PLAN-IT-B/BachelorProefTrainGame/deadlines/Blokschema/escaperoom blokschema.pdf

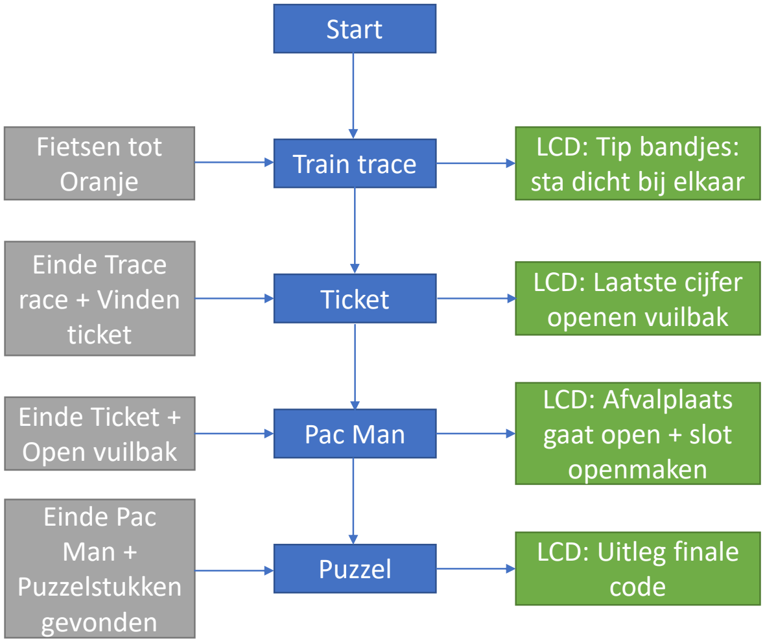
[picture p1: figure]
Train trace; Ticket; Pac Man; Puzzel; LCD: Tip bandjes: sta dicht bij elkaar; LCD: Laatste cijfer openen vuilbak; LCD: Afvalplaats gaat open + slot openmaken; LCD: Uitleg finale code; Fietsen tot Oranje; Einde Trace race + Vinden ticket; Einde Ticket + Open vuilbak; Einde Pac Man + Puzzelstukken gevonden; Start

### Minimale zone: Oranje

### Besturing via joystick

### Trein volgt de led strip

Train race (Simon Sais):
1) Eerst wordt er snel een voorbeeld route afgespeeld.
2) Deze route moet exact gevolgd worden om deze puzzel te doen slagen.

Ticket:
Vindt het ticket in de kamer, hierop staat een begin- en eindadres. Volg de kortste weg van begin tot eind om de puzzel op te lossen.

Pac Man:
Het doel van deze puzzel is om gedurende een bepaalde tijd
alle andere treinen te ontwijken. Als je lang genoeg kan blijven rijden Zonder te botsen is de puzzle opgelost.

Puzzel:
Vindt alle puzzelstukken in de kamer, en los deze op. Wanneer de puzzel Opgelost is dient deze als template om de juiste route te kunnen volgen. Als de trein deze route gevolgd heeft is deze puzzel opgelost.
