PLAN-IT-B/BachelorProefTrainGame/deadlines/PuzzelKaart.pdf

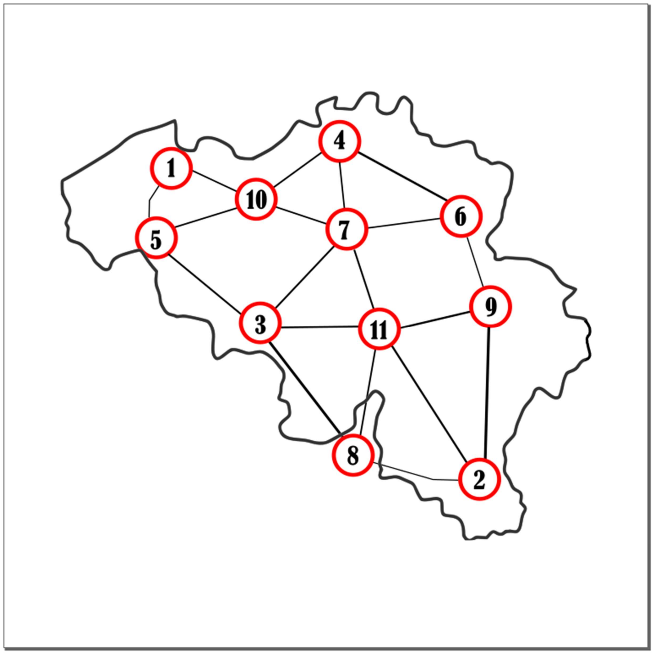
[picture p2: page 1]
