PLAN-IT-B/BachelorProefTrainGame/Verslag/3D-modellen/Puzzelstukken/TotalePuzzel.STL

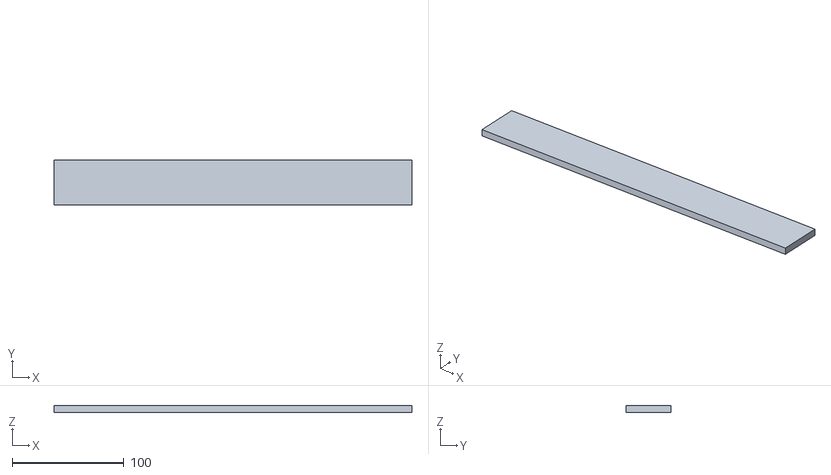
[picture p3: CAD file, 2022-05-24]
Verslag/3D-modellen/Puzzelstukken/TotalePuzzel.STL
320.0 x 40.0 x 6.00
