PLAN-IT-B/BachelorProefTrainGame/Verslag/Lasercut_Solidworks/Box/Box_totaal.SLDASM

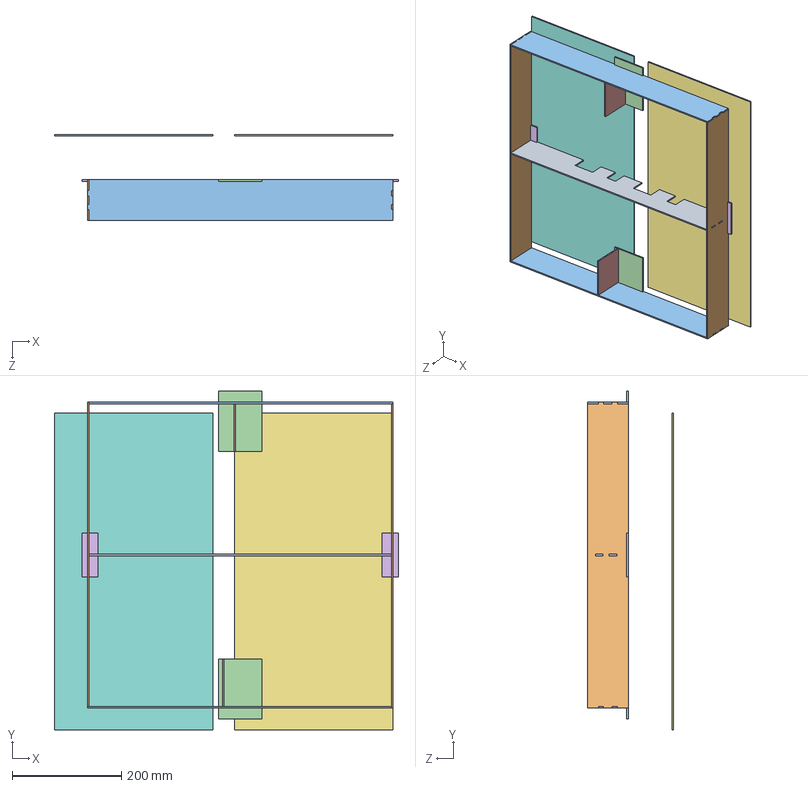
[picture p4: CAD file, 2022-05-19]
Verslag/Lasercut_Solidworks/Box/Box_totaal.SLDASM
630.0 x 620.0 x 158.0 mm
MID
SIDE_UPnDOWN x 2
SIDE_LR x 2
PLAAT_groot x 2
Ondersteuning_Mid x 2
PLAAT_klein x 2
PLAAT_boven
PLAAT_onder
