PLAN-IT-B/BachelorProefTrainGame/Verslag/3D-modellen/Bouwonderdelen Spelbord/Doos.STL

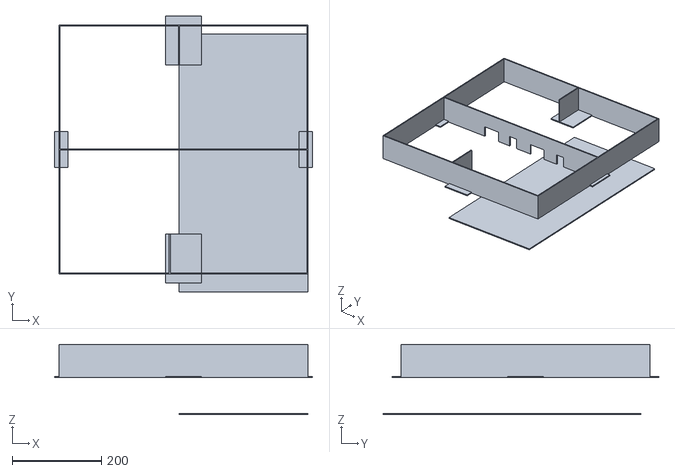
[picture p5: CAD file, 2022-05-24]
Verslag/3D-modellen/Bouwonderdelen Spelbord/Doos.STL
580.0 x 620.0 x 158.0
