PLAN-IT-B/BachelorProefTrainGame/Verslag/Lasercut_Solidworks/PUZZEL_SW/STUK_7.SLDPRT

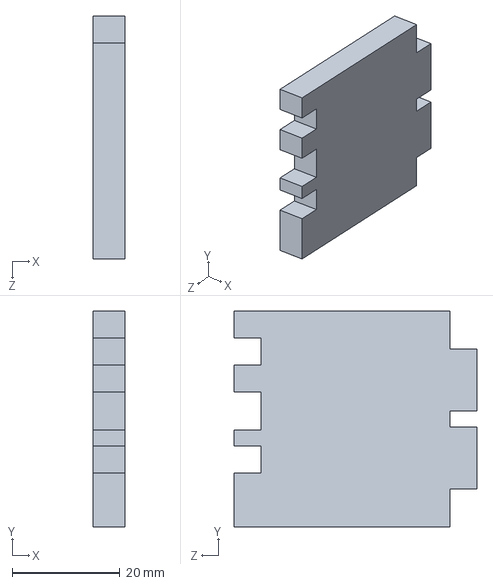
[picture p7: CAD file, 2022-05-21]
Verslag/Lasercut_Solidworks/PUZZEL_SW/STUK_7.SLDPRT
6.00 x 40.0 x 45.0 mm
