PLAN-IT-B/BachelorProefTrainGame/Verslag/3D-modellen/Bouwonderdelen Spelbord/Box_totaal - Ondersteuning_Mid-2.STL

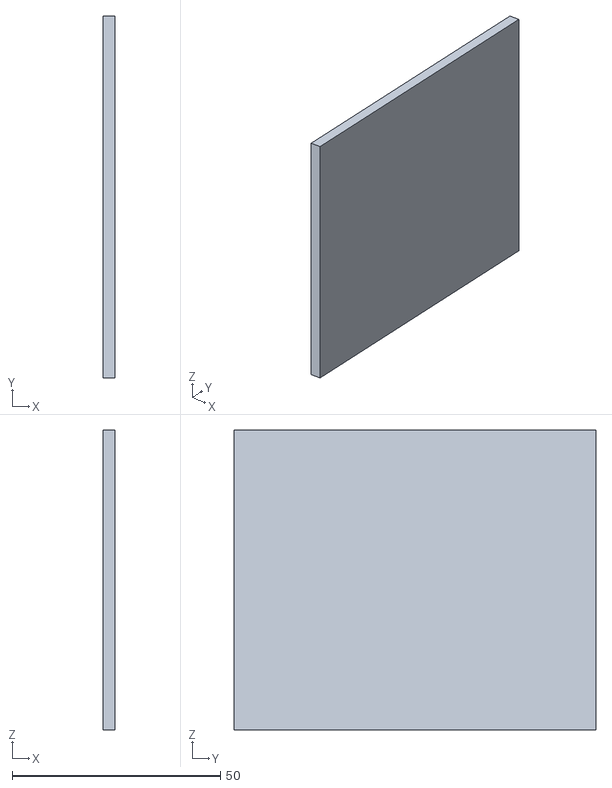
[picture p8: CAD file, 2022-05-20]
Verslag/3D-modellen/Bouwonderdelen Spelbord/Box_totaal - Ondersteuning_Mid-2.STL
3.00 x 87.0 x 72.0
