PLAN-IT-B/BachelorProefTrainGame/Verslag/3D-modellen/Puzzelstukken/PUZZEL_DXF/STUK_8.DXF

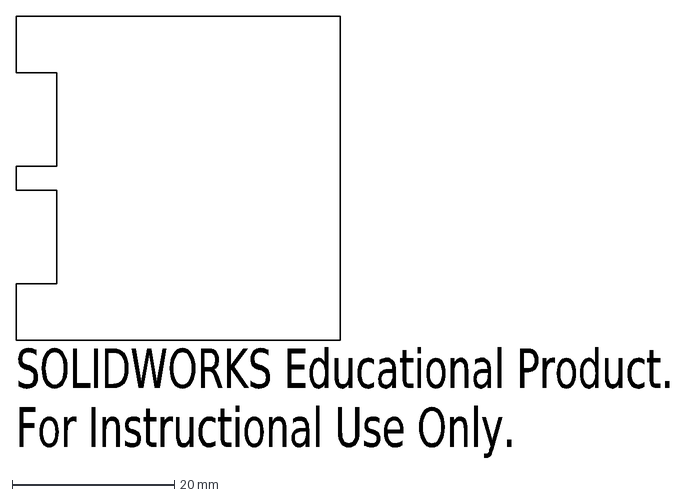
[picture p9: CAD file, 2022-05-24]
Verslag/3D-modellen/Puzzelstukken/PUZZEL_DXF/STUK_8.DXF
SOLIDWORKS Educational Product.
For Instructional Use Only.
