PLAN-IT-B/BachelorProefTrainGame/Verslag/Lasercut_Solidworks/Box/PLAAT_klein.SLDPRT

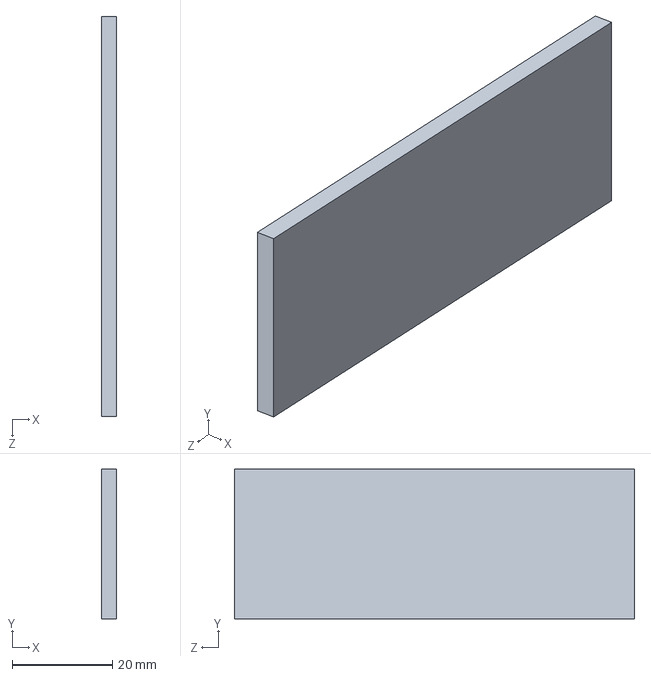
[picture p10: CAD file, 2022-05-19]
Verslag/Lasercut_Solidworks/Box/PLAAT_klein.SLDPRT
3.00 x 30.0 x 80.0 mm
