PLAN-IT-B/BachelorProefTrainGame/Verslag/3D-modellen/Bouwonderdelen Spelbord/Box_totaal - MID-1.STL

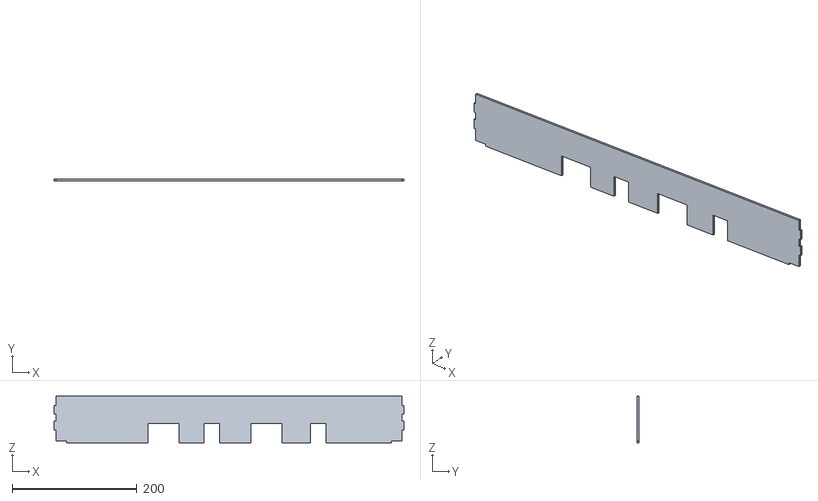
[picture p12: CAD file, 2022-05-20]
Verslag/3D-modellen/Bouwonderdelen Spelbord/Box_totaal - MID-1.STL
560.0 x 3.00 x 75.0
