PLAN-IT-B/BachelorProefTrainGame/Verslag/3D-modellen/Puzzelstukken/PUZZEL_DXF/STUK_6.DXF

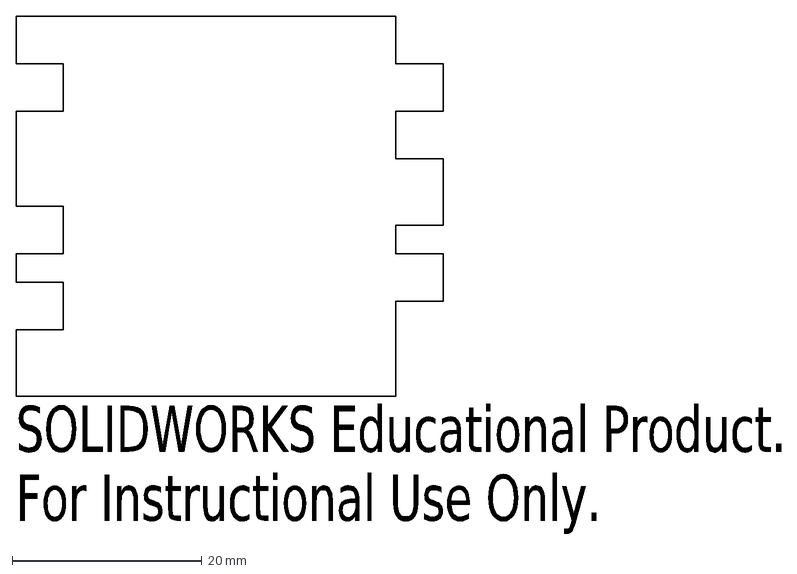
[picture p13: CAD file, 2022-05-24]
Verslag/3D-modellen/Puzzelstukken/PUZZEL_DXF/STUK_6.DXF
SOLIDWORKS Educational Product.
For Instructional Use Only.
