PLAN-IT-B/BachelorProefTrainGame/Verslag/Lasercut_Solidworks/Box/SIDE_UPnDOWN.SLDPRT

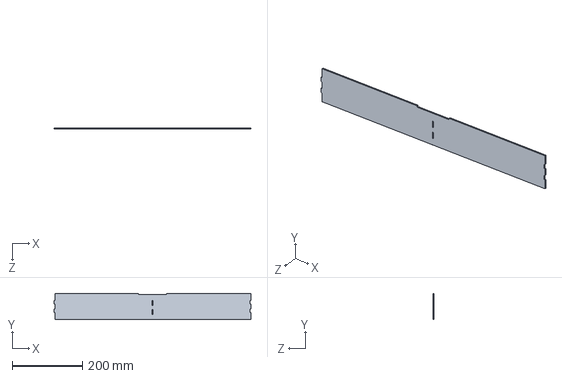
[picture p14: CAD file, 2022-05-19]
Verslag/Lasercut_Solidworks/Box/SIDE_UPnDOWN.SLDPRT
560.0 x 75.0 x 3.00 mm
