PLAN-IT-B/BachelorProefTrainGame/Verslag/Lasercut_Solidworks/Box/PLAAT_boven.SLDPRT

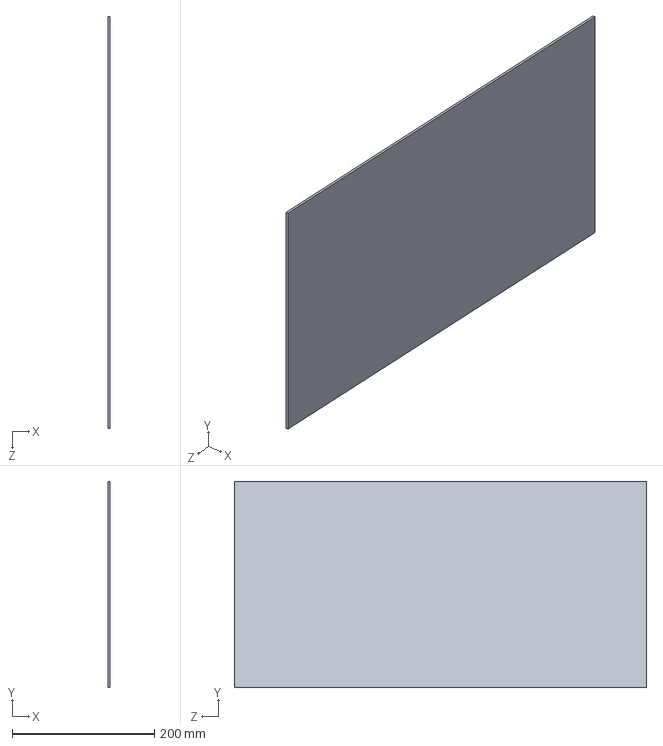
[picture p16: CAD file, 2022-05-19]
Verslag/Lasercut_Solidworks/Box/PLAAT_boven.SLDPRT
3.00 x 290.0 x 580.0 mm
