PLAN-IT-B/BachelorProefTrainGame/Verslag/3D-modellen/Bouwonderdelen Spelbord/Box_totaal - PLAAT_groot-3.STL

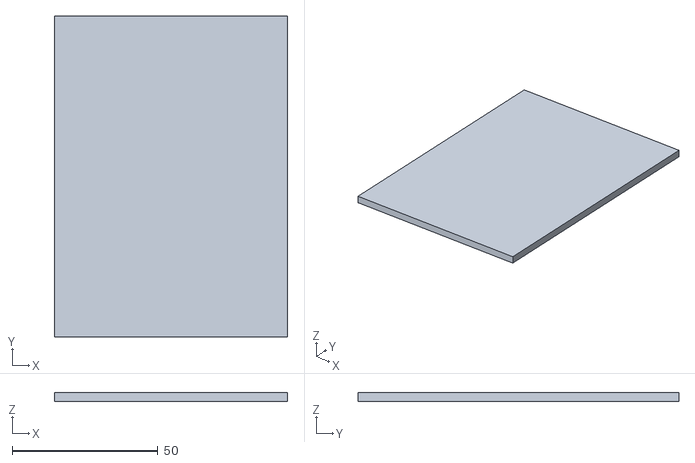
[picture p17: CAD file, 2022-05-20]
Verslag/3D-modellen/Bouwonderdelen Spelbord/Box_totaal - PLAAT_groot-3.STL
80.0 x 110.0 x 3.00
