PLAN-IT-B/BachelorProefTrainGame/Verslag/Lasercut_Solidworks/PUZZEL_SW/STUK_8.SLDPRT

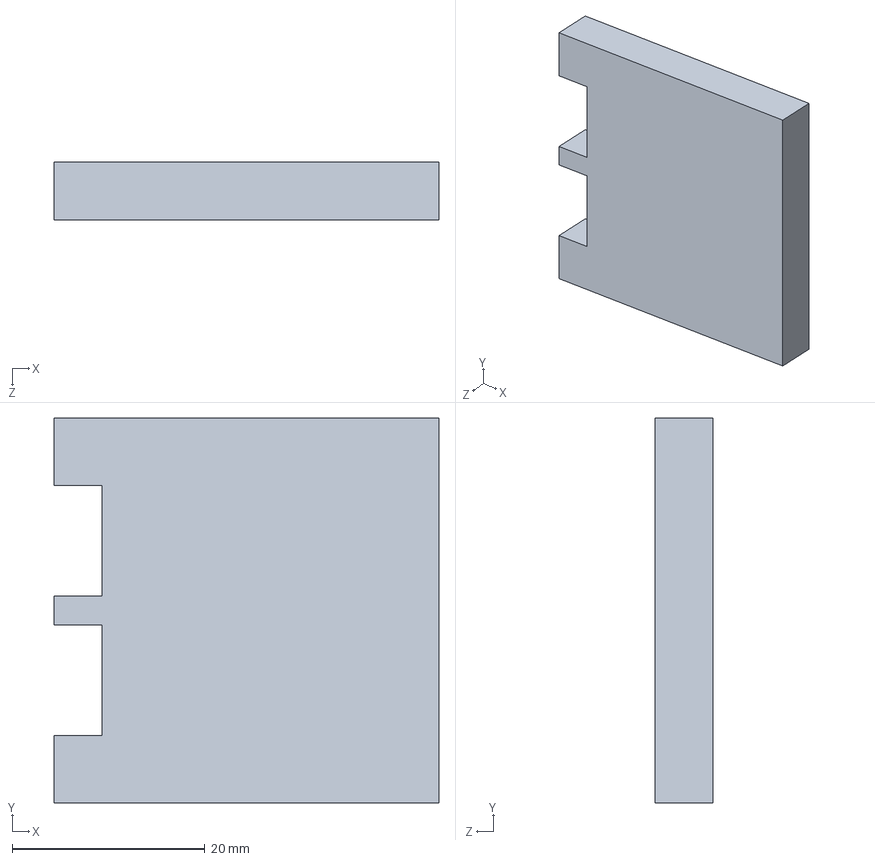
[picture p19: CAD file, 2022-05-21]
Verslag/Lasercut_Solidworks/PUZZEL_SW/STUK_8.SLDPRT
40.0 x 40.0 x 6.00 mm
