PLAN-IT-B/BachelorProefTrainGame/(list of files, cad)

Other CAD files:
Verslag/Lasercut_Solidworks/PUZZEL_SW/Assem1.SLDASM
Verslag/3D-modellen/Puzzelstukken/STUK_2.STL
Verslag/Lasercut_Solidworks/PUZZEL_SW/STUK_4.SLDPRT
Verslag/3D-modellen/Bouwonderdelen Spelbord/Box_totaal - Ondersteuning_Mid-1.STL
Verslag/3D-modellen/Puzzelstukken/STUK_7.STL
Verslag/Lasercut_Solidworks/Box/Ondersteuning_Mid.SLDPRT
Verslag/Lasercut_Solidworks/PUZZEL_SW/STUK_6.SLDPRT
Verslag/3D-modellen/Puzzelstukken/STUK_1.STL
Verslag/Lasercut_Solidworks/PUZZEL_SW/STUK_5.SLDPRT
Verslag/3D-modellen/Bouwonderdelen Spelbord/Box_totaal - SIDE_UPnDOWN-2.STL
Verslag/3D-modellen/Puzzelstukken/STUK_3.STL
Verslag/3D-modellen/Puzzelstukken/STUK_5.STL
Verslag/Lasercut_Solidworks/Box/SIDE_LR.SLDPRT
Verslag/3D-modellen/Bouwonderdelen Spelbord/Box_totaal - SIDE_LR-3.STL
Verslag/3D-modellen/Puzzelstukken/STUK_6.STL
Verslag/Lasercut_Solidworks/Box/PLAAT_groot.SLDPRT
Verslag/Lasercut_Solidworks/PUZZEL_SW/STUK_2.SLDPRT
Verslag/3D-modellen/Bouwonderdelen Spelbord/Box_totaal - PLAAT_klein-1.STL
Verslag/3D-modellen/Puzzelstukken/STUK_4.STL
Verslag/Lasercut_Solidworks/Box/MID.SLDPRT
Verslag/Lasercut_Solidworks/PUZZEL_SW/STUK_3.SLDPRT
Verslag/3D-modellen/Bouwonderdelen Spelbord/Box_totaal - PLAAT_klein-2.STL
Verslag/3D-modellen/Puzzelstukken/STUK_8.STL
Verslag/Lasercut_Solidworks/PUZZEL_SW/STUK_1.SLDPRT
Verslag/3D-modellen/Bouwonderdelen Spelbord/Box_totaal - SIDE_UPnDOWN-3.STL
Verslag/3D-modellen/Bouwonderdelen Spelbord/Box_totaal - SIDE_LR-2.STL
Verslag/3D-modellen/Bouwonderdelen Spelbord/Box_totaal - PLAAT_groot-1.STL
Verslag/3D-modellen/Bouwonderdelen Spelbord/Box_totaal - PLAAT_boven-1.STL
Verslag/3D-modellen/Bouwonderdelen Spelbord/Box_totaal - PLAAT_onder-1.STL
