PLAN-IT-B/BachelorProefTrainGame/Verslag/PCB/FINAL_SCH.kicad_pcb

## KiCad design Verslag/PCB/FINAL_SCH.kicad_pcb (2022-05-19)

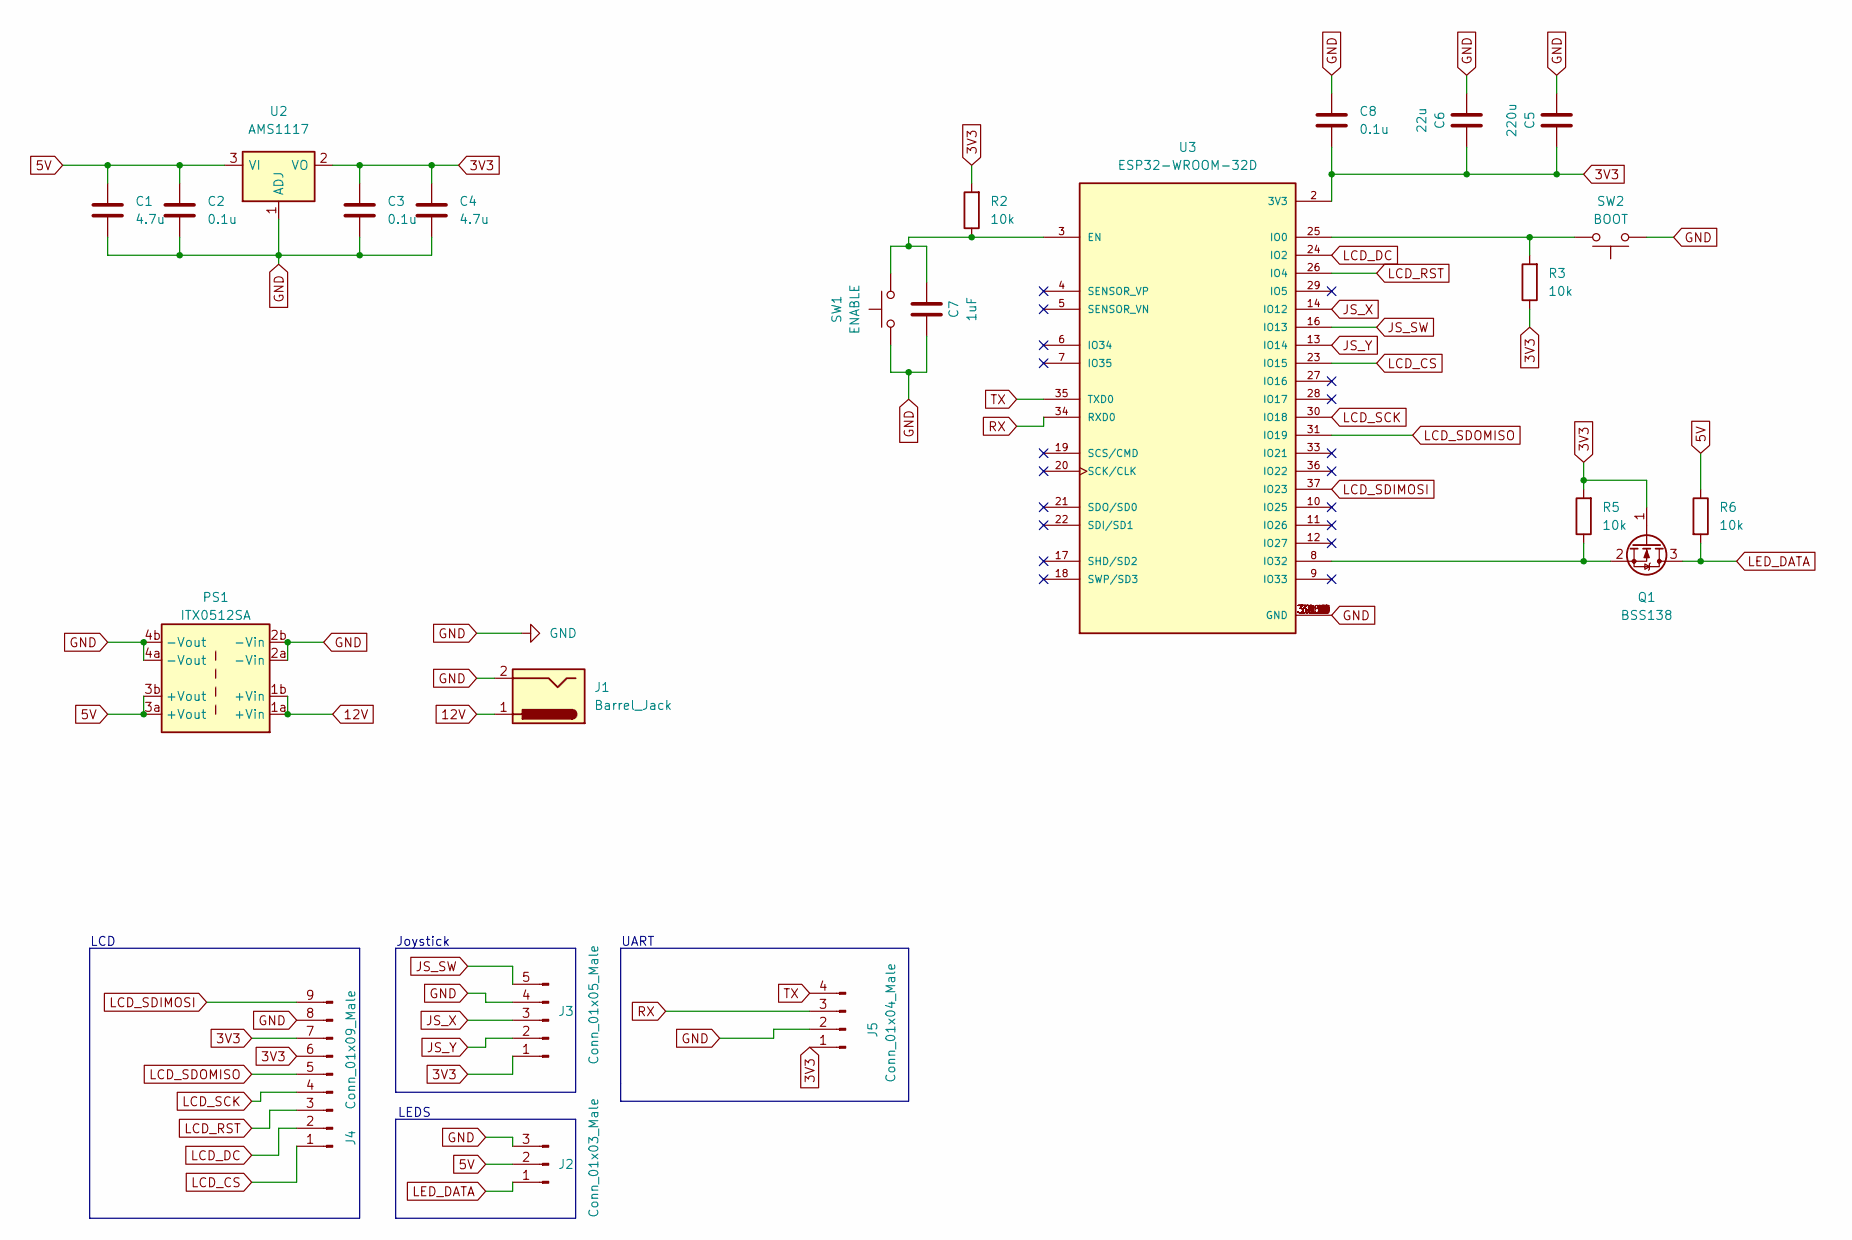
[picture p22: schematic FINAL_SCH.kicad_sch]

Parts:
C1, C4: 4.7u; C_0805_2012Metric
C2, C3, C8: 0.1u; C_0805_2012Metric
C5: 220u; C_0805_2012Metric
C6: 22u; C_0805_2012Metric
C7: 1uF; C_0805_2012Metric
J1: Barrel_Jack; BarrelJack_GCT_DCJ200-10-A_Horizontal
J2: Conn_01x03_Male; PinHeader_1x03_P2.54mm_Vertical
J3: Conn_01x05_Male; PinHeader_1x05_P2.54mm_Vertical
J4: Conn_01x09_Male; PinSocket_1x09_P2.54mm_Vertical
J5: Conn_01x04_Male; PinHeader_1x04_P2.54mm_Vertical
PS1: ITX0512SA; Buck_Converter
Q1: BSS138; SOT-23
R2, R3, R5, R6: 10k; R_1206_3216Metric
SW1: ENABLE; SW_1825910-6-4
SW2: BOOT; SW_1825910-6-4
U2: AMS1117; SOT-223-3_TabPin2
U3: ESP32-WROOM-32D; MODULE_ESP32-WROOM-32D; PARTREV 1.9

Connections:
3V3: C3.1, C4.1, C5.2, C6.2, C8.2, J3.1, J4.6, J4.7, J5.1, Q1.1 (G), R2.2, R3.1, R5.2, U2.2 (VO), U3.2 (3V3)
5V: C1.1, C2.1, J2.2, PS1.3a (+Vout), PS1.3b (+Vout), R6.1, U2.3 (VI)
12V: J1.1, PS1.1a (+Vin), PS1.1b (+Vin)
GND: C1.2, C2.2, C3.2, C4.2, C5.1, C6.1, C7.1, C8.1, J1.2, J2.3, J3.4, J4.8, J5.2, PS1.2a (-Vin), PS1.2b (-Vin), PS1.4a (-Vout), PS1.4b (-Vout), SW1.1, SW2.2, U2.1 (ADJ), U3.1 (GND), U3.15 (GND), U3.38 (GND), U3.39_1 (GND), U3.39_2 (GND), U3.39_3 (GND), U3.39_4 (GND), U3.39_5 (GND), U3.39_6 (GND), U3.39_7 (GND), U3.39_8 (GND), U3.39_9 (GND), U3.39_10 (GND), U3.39_11 (GND), U3.39_12 (GND), U3.39_13 (GND), U3.39_14 (GND), U3.39_15 (GND), U3.39_16 (GND), U3.39_17 (GND), U3.39_18 (GND), U3.39_19 (GND), U3.39_20 (GND), U3.39_21 (GND)
JS_SW: J3.5, U3.16 (IO13)
JS_X: J3.3, U3.14 (IO12)
JS_Y: J3.2, U3.13 (IO14)
LCD_CS: J4.1, U3.23 (IO15)
LCD_DC: J4.2, U3.24 (IO2)
LCD_RST: J4.3, U3.26 (IO4)
LCD_SCK: J4.4, U3.30 (IO18)
LCD_SDIMOSI: J4.9, U3.37 (IO23)
LCD_SDOMISO: J4.5, U3.31 (IO19)
LED_DATA: J2.1, Q1.3 (D), R6.2
unnamed: C7.2, R2.1, SW1.2, U3.3 (EN)
unnamed: Q1.2 (S), R5.1, U3.8 (IO32)
unnamed: R3.2, SW2.1, U3.25 (IO0)
RX: J5.3, U3.34 (RXD0)
TX: J5.4, U3.35 (TXD0)

Notes on the sheet:
LCD
Joystick
LEDS
UART

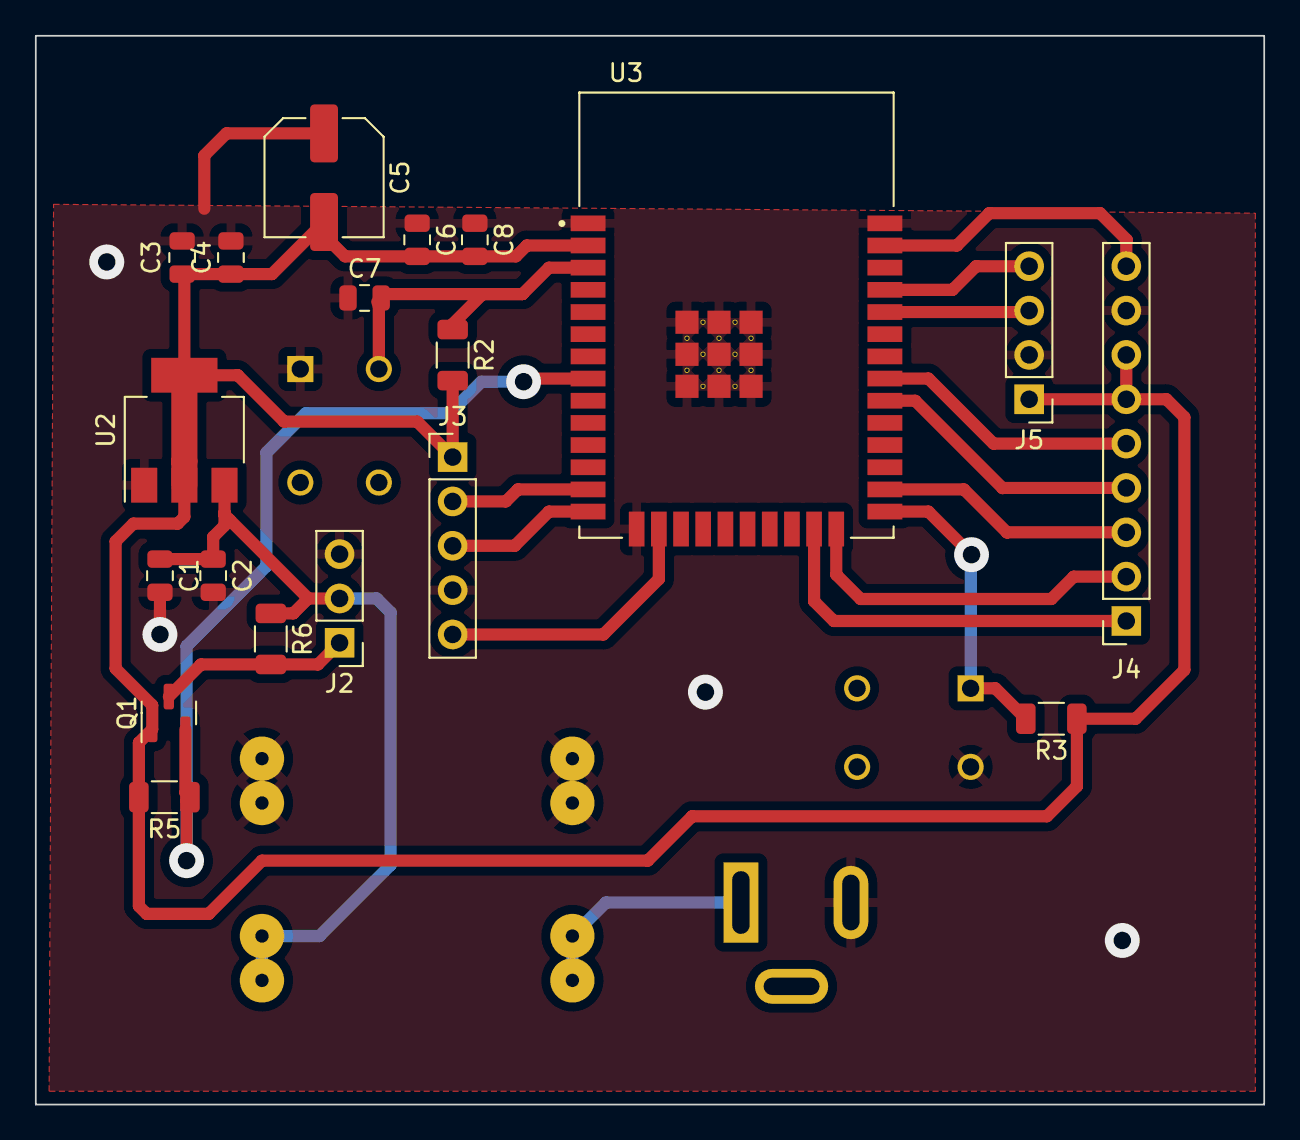
[picture p23: board FINAL_SCH.kicad_pcb from above]

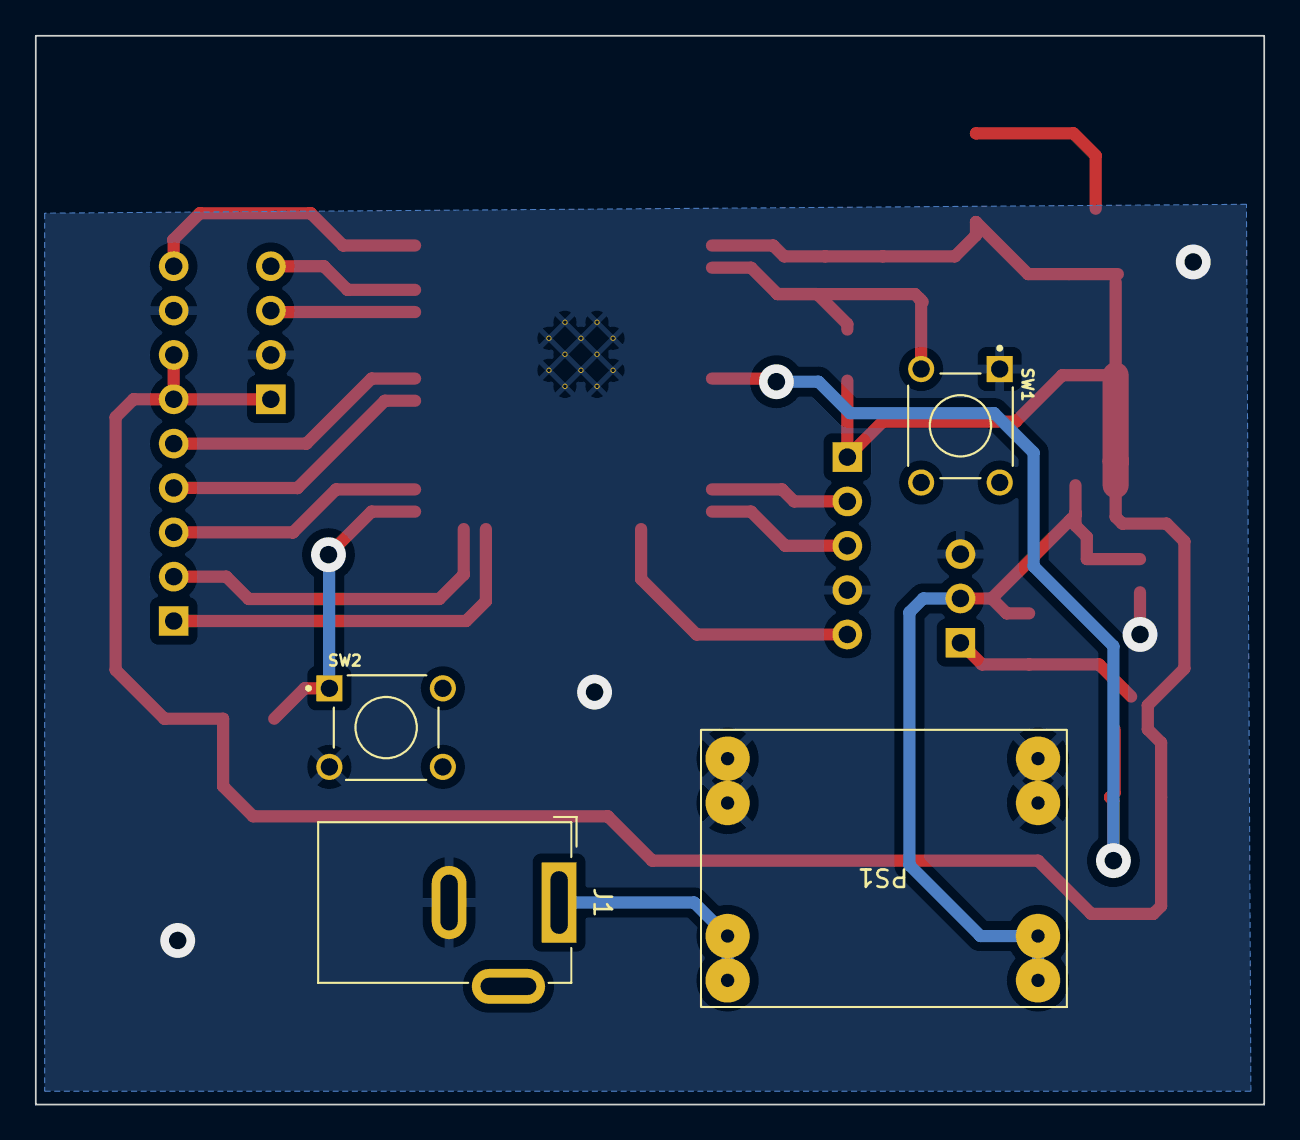
[picture p24: board FINAL_SCH.kicad_pcb from below]

Board: 2 copper layers, 70.4 x 61.2 mm, 23 parts (4 on the bottom side), 19 nets.
