PLAN-IT-B/BachelorProefTrainGame/src/Drukknop.cpp

#include "Drukknop.h"
#define M_PI		3.14159265358979323846
#include <math.h>


/*double Drukknop::bepaalZone(int x, int y){
    x=-2000;
    y=-2000;
    double rad= atan(y/x);
    double hoek=(rad/M_PI)*360;
    int zone;
    if(0<=hoek<30) zone=10;
    if(30<=hoek<60) zone=11;
    if(60<=hoek<90) zone=12;
    if(90<=hoek<120) zone=1;
    if(120<=hoek<150) zone=2;
    if(150<=hoek<180) zone=3;
    if(180<=hoek<210) zone=4;
    if(210<=hoek<240) zone=5;
    if(240<=hoek<270) zone=6;
    if(270<=hoek<300) zone=7;
    if(300<=hoek<330) zone=8;
    if(330<=hoek<=359) zone=9;   
    if(deadZone(x,y)) zone = 0;
<<<<<<< HEAD
    return hoek;

} */
=======
    else zone = -1;
    return zone;
>>>>>>> 98fb19ce7457df0af03b6d1cd34979562a205bd2


bool Drukknop::deadZone(int x, int y){
    x=-2000;
    y=-2000;
    double afst= sqrt(x*x+y*y);
    return afst>afstand_deadzone;
}
