PLAN-IT-B/BachelorProefTrainGame/(commit log)

2022-02-22 Create timeline - Escape Room.xlsx
    gantt-chart
    [timeline - Escape Room.xlsx]
2022-02-22 Add blokschema
    [timeline - Escape Room.xlsx]
2022-03-08 faal
    bogus code
    [timeline - Escape Room.xlsx]
2022-05-20 STL-files puzzel
    [STUK_1.STL, STUK_2.STL, STUK_3.STL, STUK_4.STL, STUK_5.STL, STUK_6.STL, STUK_7.STL, STUK_8.STL]
2022-05-20 Extra modellen
    [STUK_1.STL, STUK_2.STL, STUK_3.STL, STUK_4.STL, STUK_5.STL, STUK_6.STL, STUK_7.STL, STUK_8.STL]
2022-05-21 Opruimen en sorteren
    [Assem1.SLDASM, Box_totaal - MID-1.STL, Box_totaal - Ondersteuning_Mid-1.STL, Box_totaal - Ondersteuning_Mid-2.STL, Box_totaal - PLAAT_boven-1.STL, Box_totaal - PLAAT_groot-1.STL, Box_totaal - PLAAT_groot-3.STL, Box_totaal - PLAAT_klein-1.STL]
